Ruiqi-Deng/cyberluban-campuscar-group4/mechanical/Images/Overall-2.png

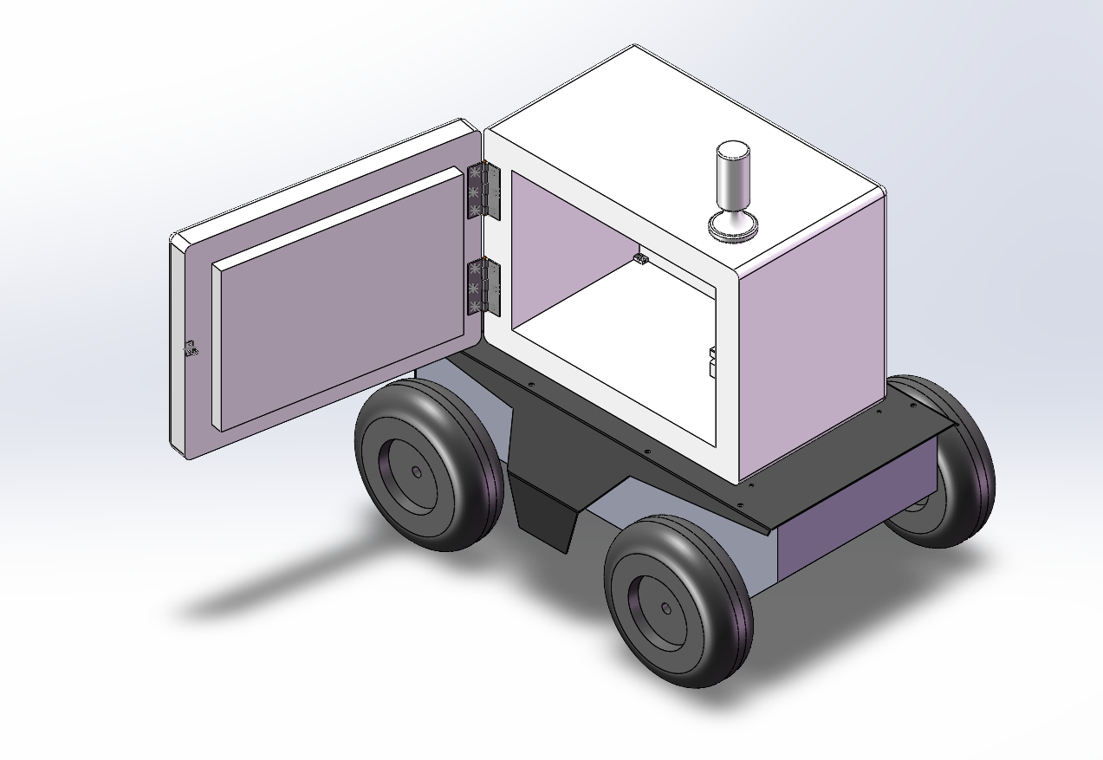
mechanical/Images/Overall-2.png
