Ruiqi-Deng/cyberluban-campuscar-group4/docs/测试记录/rtk天线/images/串口通信_POS帧.png

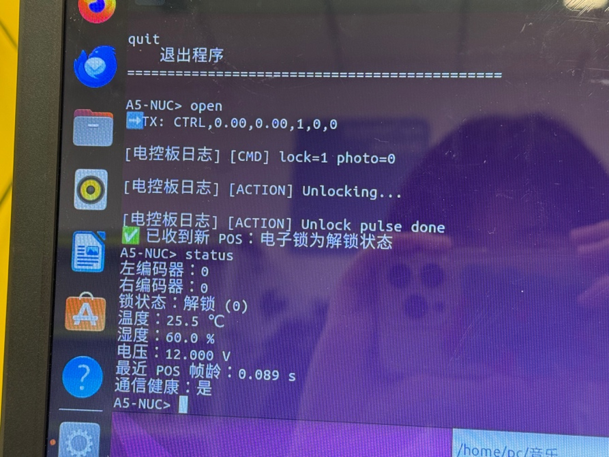
docs/测试记录/rtk天线/images/串口通信_POS帧.png
