Ruiqi-Deng/cyberluban-campuscar-group4/docs/测试记录/电子锁+温湿度传感器/电子锁+温湿度传感器联调记录.md

# 温湿度传感器 + 电子锁 联调日志

**测试人员**：杨飞扬
**测试日期**：2026年8月20日  
**测试环境**：ESP32 + AM2301(DHT22) + 12V电磁锁 + 继电器

## 测试结果

- AM2301 温湿度读取正常（22.5°C / 78.8%）
- 电子锁开关控制正常（LOCKED ↔ UNLOCKED）
- POS帧数据上报正常（温湿度+锁状态+电压）
- 串口通信稳定

## 证据

联调截图
