Ruiqi-Deng/cyberluban-campuscar-group4/docs/测试记录/rtk天线/images/rtk_数据传送.png

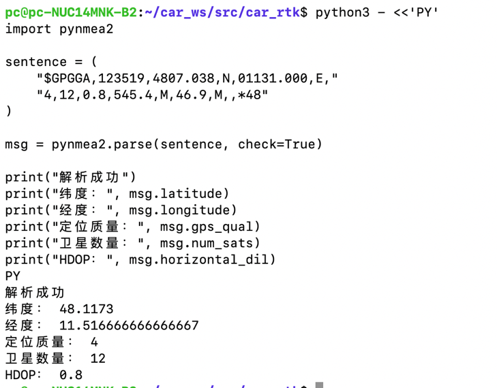
docs/测试记录/rtk天线/images/rtk_数据传送.png
