Ruiqi-Deng/cyberluban-campuscar-group4/docs/测试记录/rtk天线/images/状态机_状态流转截图.png

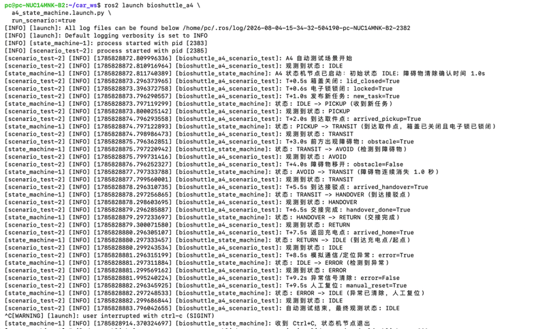
docs/测试记录/rtk天线/images/状态机_状态流转截图.png
