Ruiqi-Deng/cyberluban-campuscar-group4/docs/测试记录/电子锁+温湿度传感器/images/电子锁与温湿度传感器联调2.png

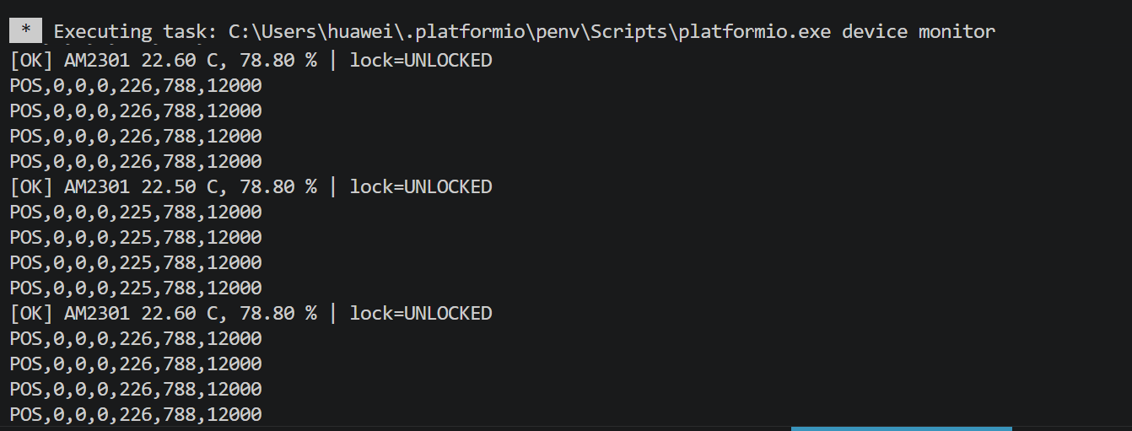
docs/测试记录/电子锁+温湿度传感器/images/电子锁与温湿度传感器联调2.png
