Ruiqi-Deng/cyberluban-campuscar-group4/mechanical/Images/Drawing Document.png

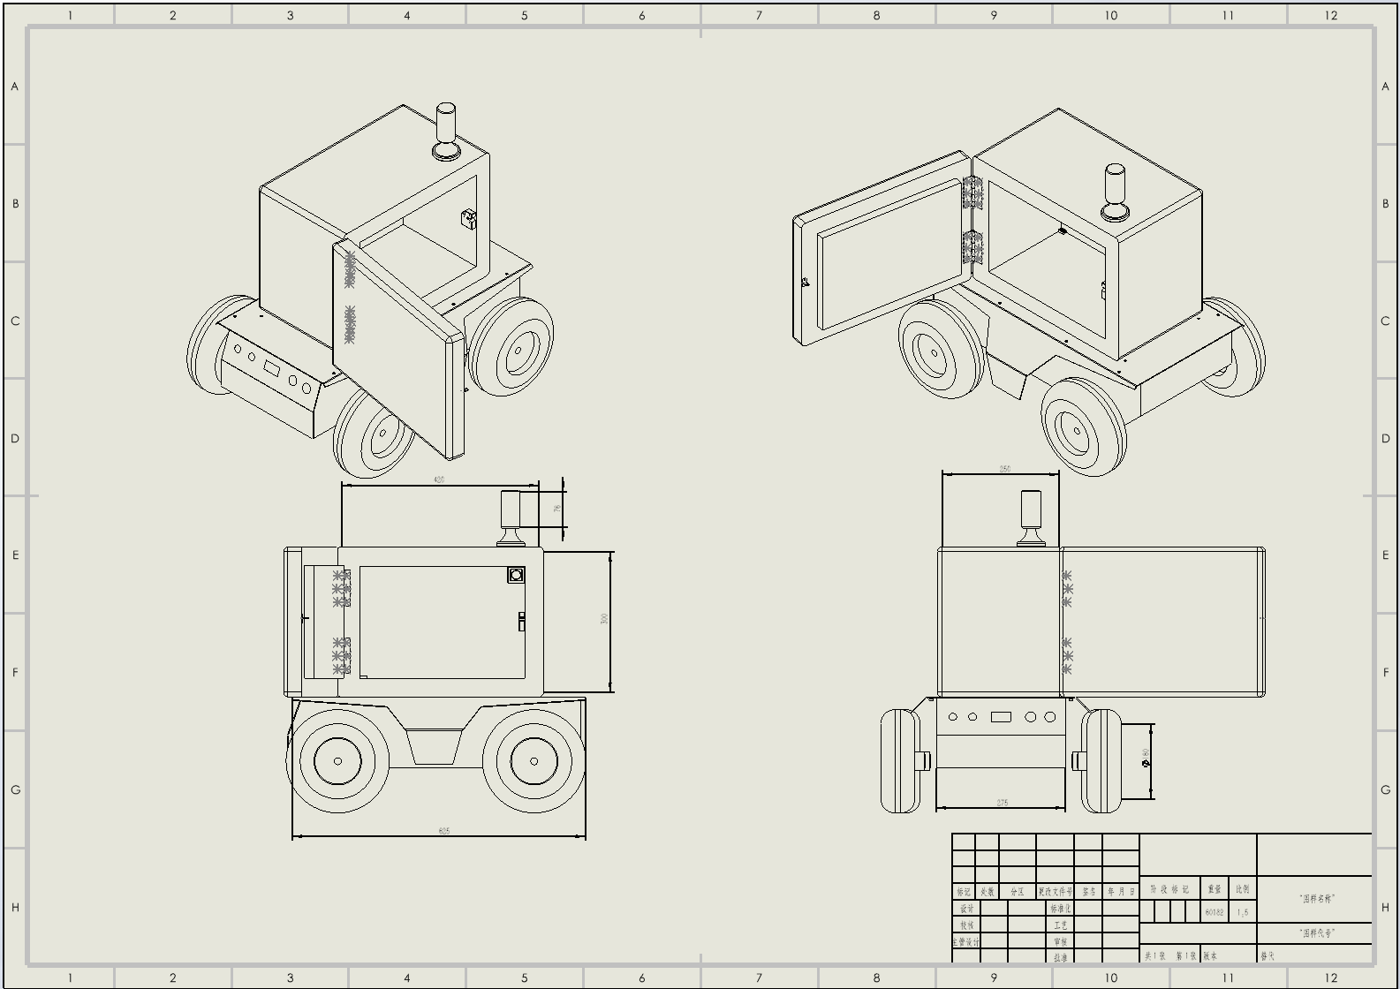
mechanical/Images/Drawing Document.png
