Ruiqi-Deng/cyberluban-campuscar-group4/mechanical/Images/Overall-1.png

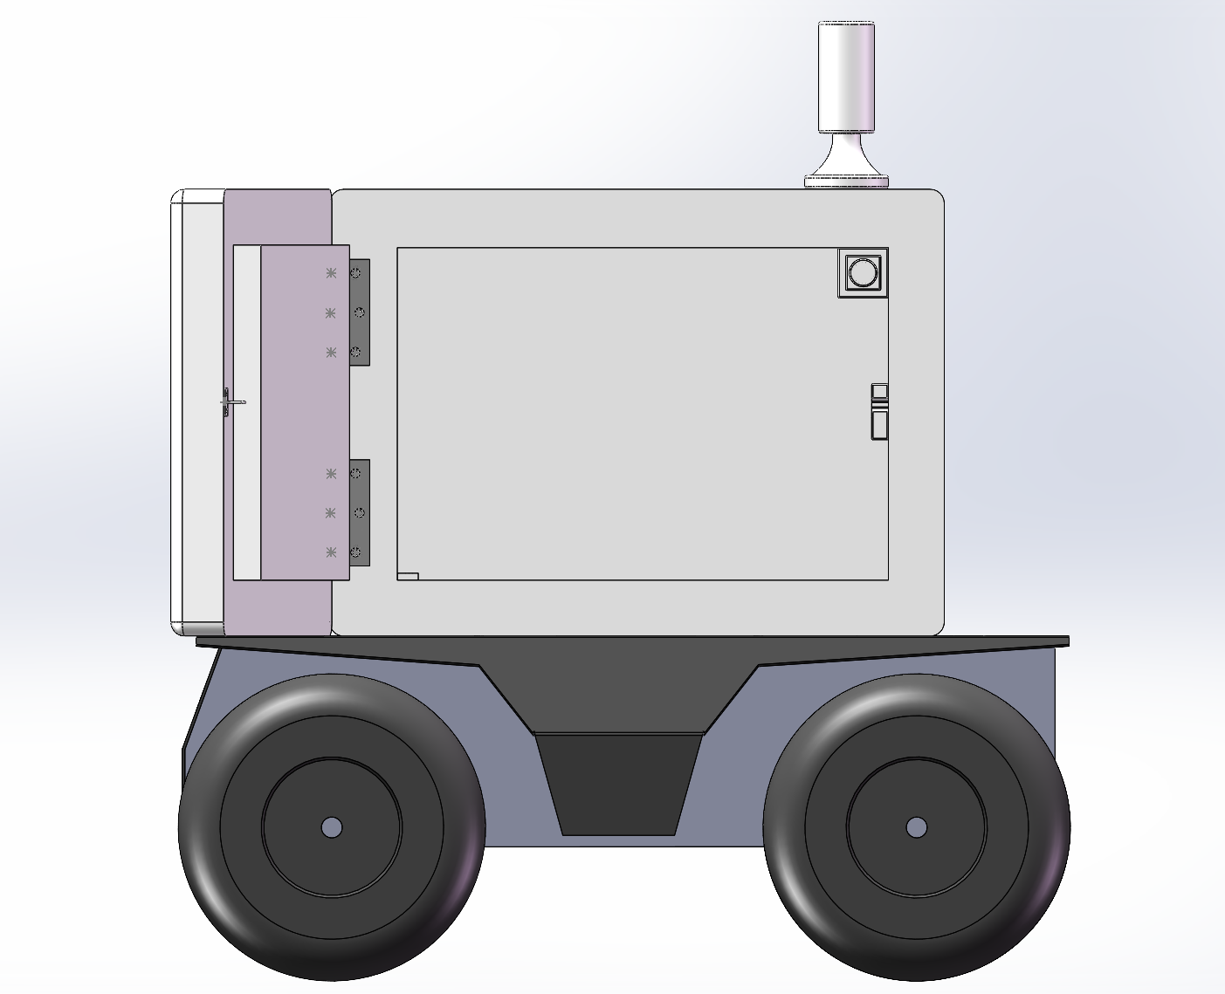
mechanical/Images/Overall-1.png
