Ruiqi-Deng/cyberluban-campuscar-group4/mechanical/Images/Overall-3.png

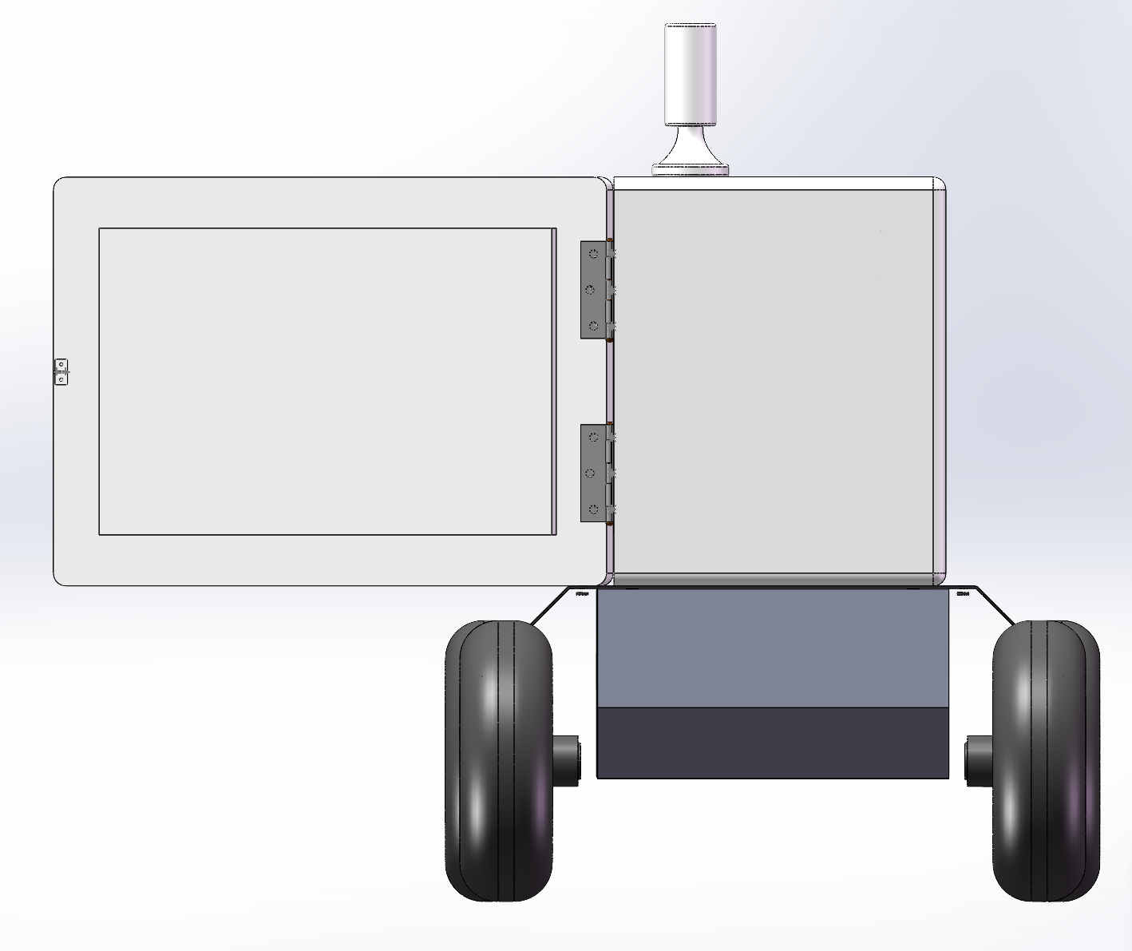
mechanical/Images/Overall-3.png
