Ruiqi-Deng/cyberluban-campuscar-group4/mechanical/Images/Overall-4.png

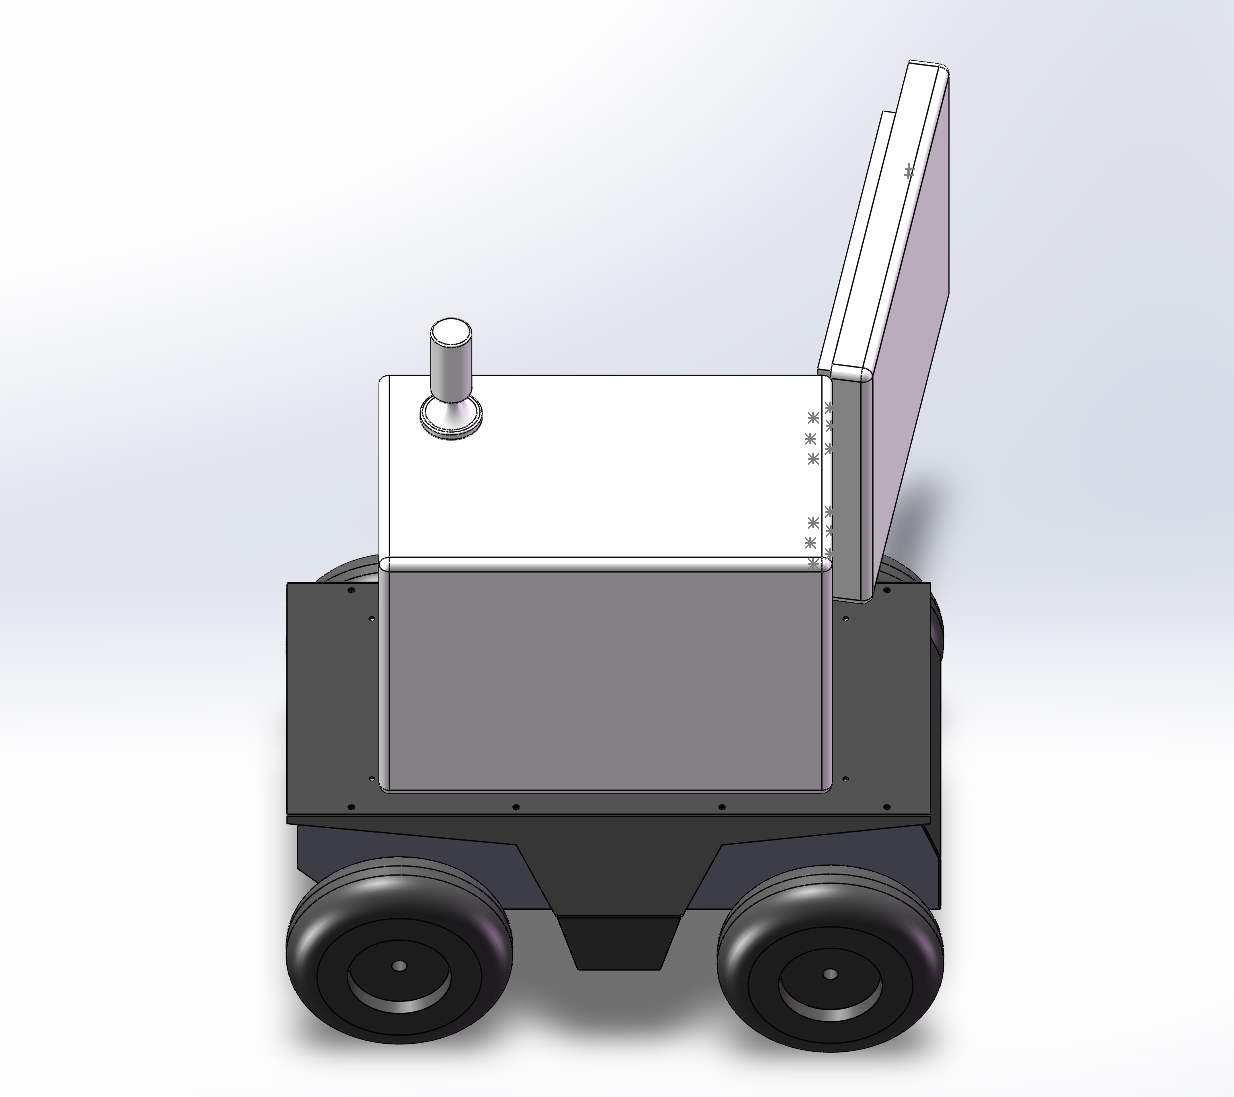
mechanical/Images/Overall-4.png
