Ruiqi-Deng/cyberluban-campuscar-group4/mechanical/CAD/箱体.SLDPRT

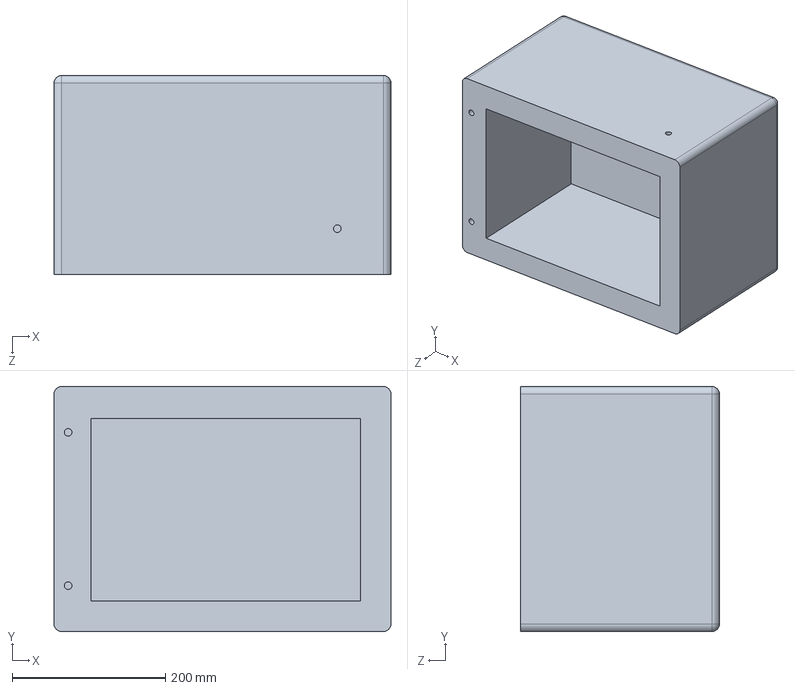
[picture p11: CAD file, 2026-08-21]
mechanical/CAD/箱体.SLDPRT
440.0 x 320.0 x 260.0 mm
