Ruiqi-Deng/cyberluban-campuscar-group4/mechanical/CAD/天线.SLDPRT

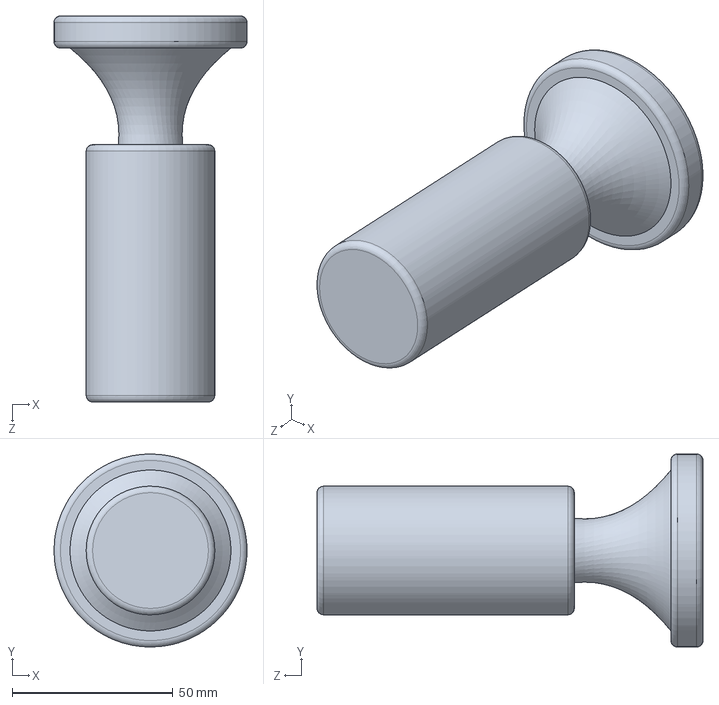
[picture p12: CAD file, 2026-08-21]
mechanical/CAD/天线.SLDPRT
60.0 x 60.0 x 120.0 mm
