Ruiqi-Deng/cyberluban-campuscar-group4/mechanical/CAD/四驱车.SLDPRT

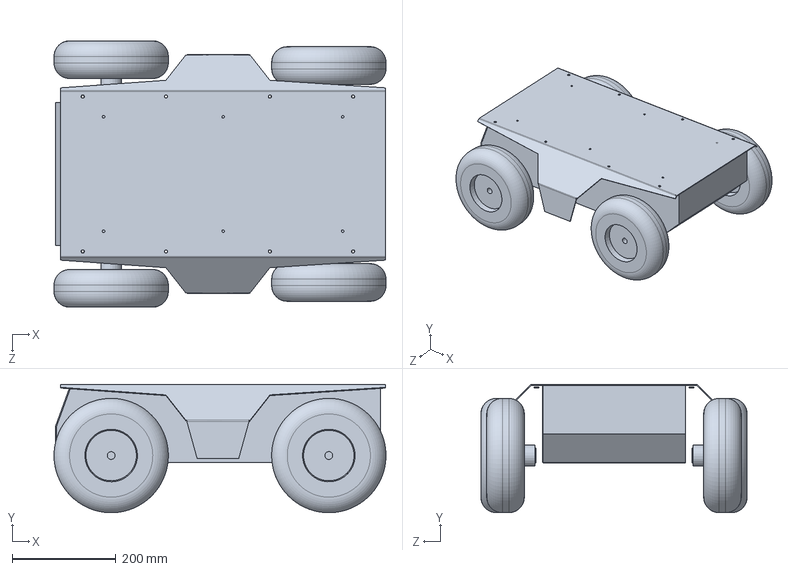
[picture p13: CAD file, 2026-08-20]
mechanical/CAD/四驱车.SLDPRT
638.6 x 247.0 x 512.4 mm
