Ruiqi-Deng/cyberluban-campuscar-group4/mechanical/CAD/箱盖.SLDPRT

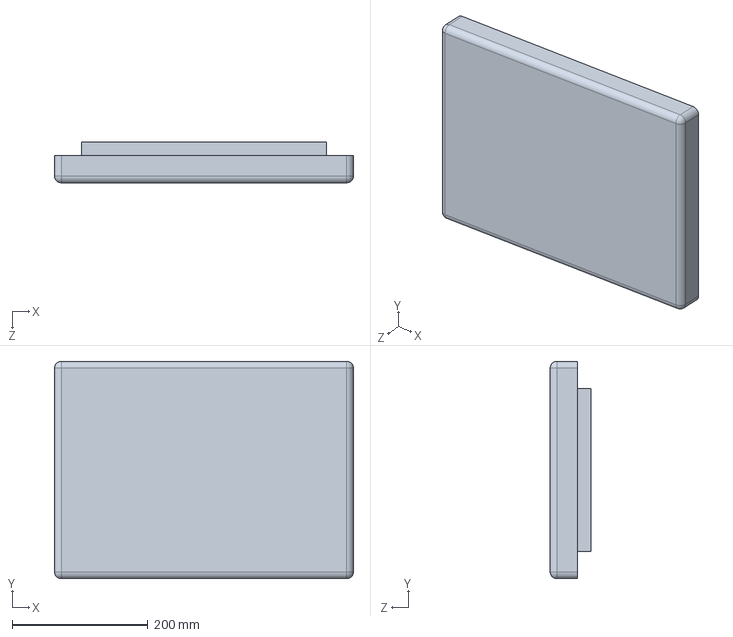
[picture p14: CAD file, 2026-08-20]
mechanical/CAD/箱盖.SLDPRT
440.0 x 320.0 x 60.0 mm
