Ruiqi-Deng/cyberluban-campuscar-group4/mechanical/CAD/转轴.SLDPRT

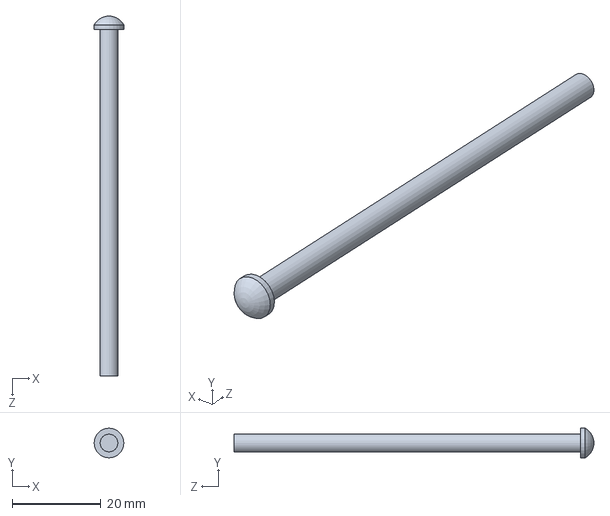
[picture p15: CAD file, 2026-08-20]
mechanical/CAD/转轴.SLDPRT
6.70 x 6.70 x 81.0 mm
