Ruiqi-Deng/cyberluban-campuscar-group4/mechanical/CAD/电子锁锁扣.SLDPRT

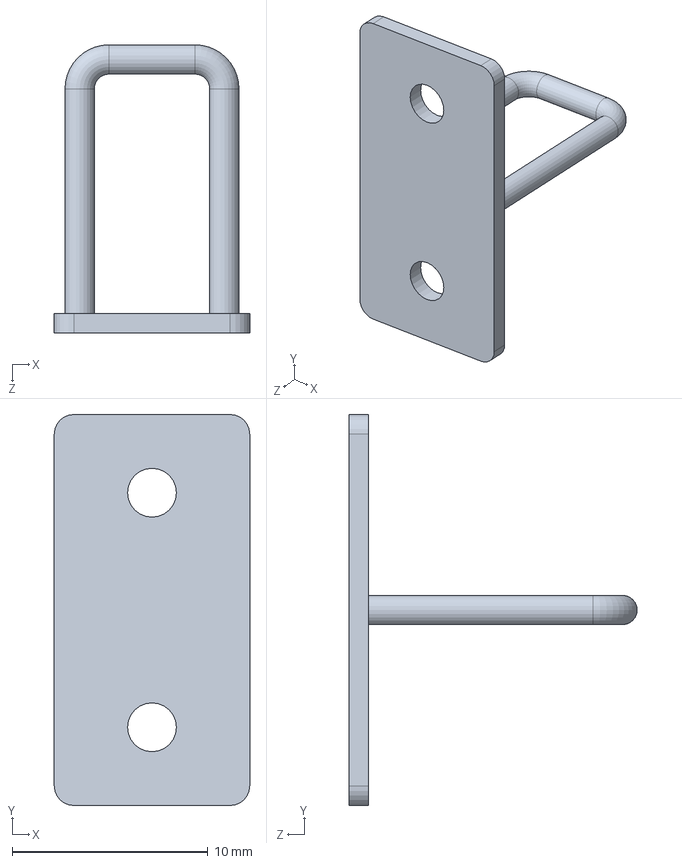
[picture p16: CAD file, 2026-08-20]
mechanical/CAD/电子锁锁扣.SLDPRT
10.0 x 20.0 x 14.8 mm
