Ruiqi-Deng/cyberluban-campuscar-group4/mechanical/CAD/电子锁锁体.SLDPRT

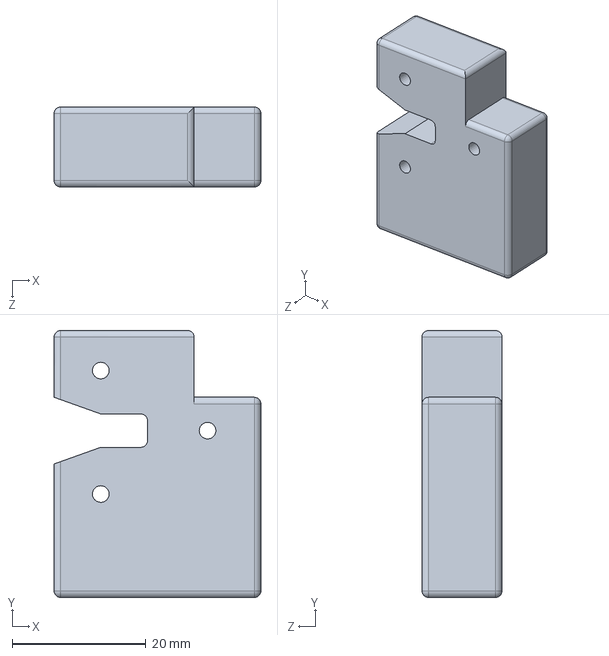
[picture p17: CAD file, 2026-08-20]
mechanical/CAD/电子锁锁体.SLDPRT
31.0 x 40.0 x 12.0 mm
