Ruiqi-Deng/cyberluban-campuscar-group4/mechanical/CAD/温湿度传感器.SLDPRT

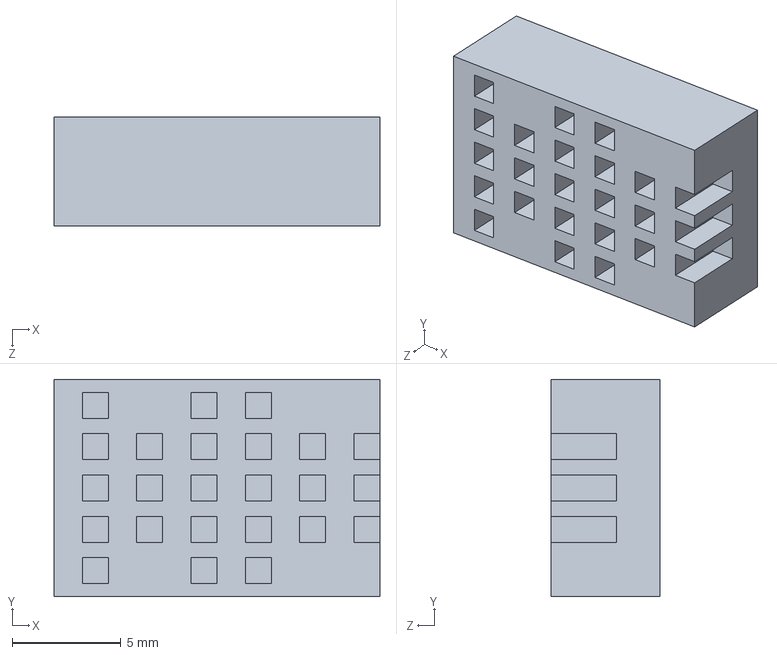
[picture p18: CAD file, 2026-08-20]
mechanical/CAD/温湿度传感器.SLDPRT
15.0 x 10.0 x 5.00 mm
