Ruiqi-Deng/cyberluban-campuscar-group4/mechanical/CAD/合页夹.SLDPRT

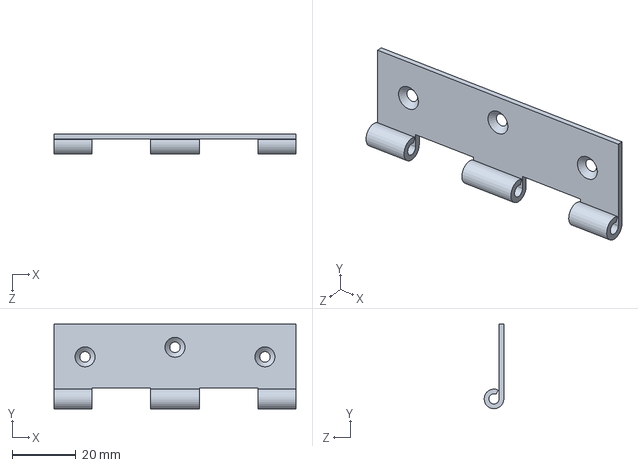
[picture p19: CAD file, 2026-08-20]
mechanical/CAD/合页夹.SLDPRT
76.0 x 26.5 x 6.20 mm
