Ruiqi-Deng/cyberluban-campuscar-group4/mechanical/CAD/相机.SLDPRT

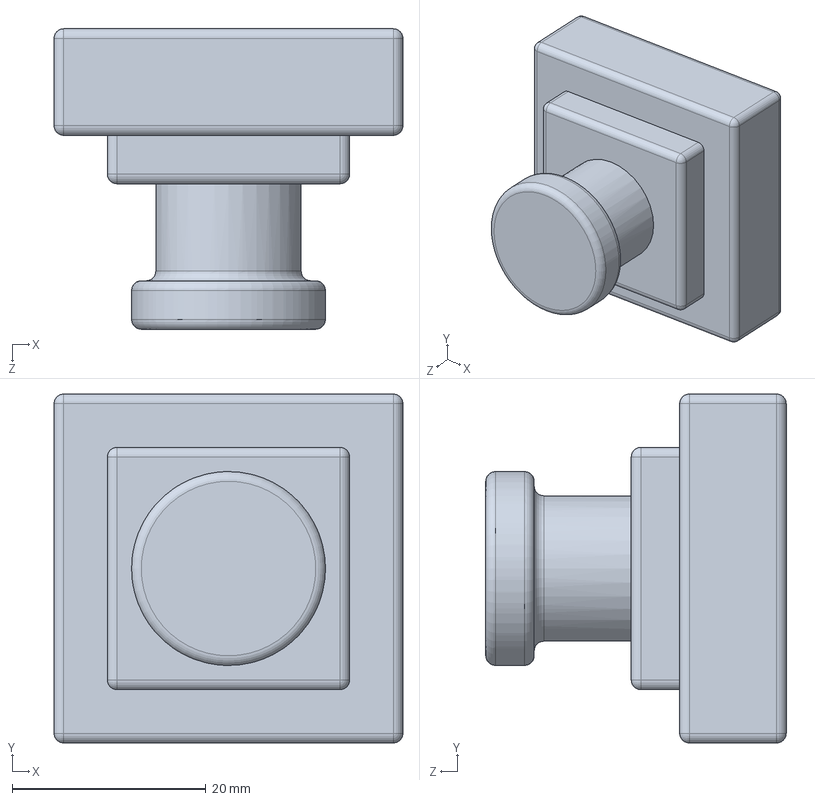
[picture p20: CAD file, 2026-08-20]
mechanical/CAD/相机.SLDPRT
36.0 x 36.0 x 31.0 mm
