Ruiqi-Deng/cyberluban-campuscar-group4/mechanical/CAD/接驳车装配体.SLDASM

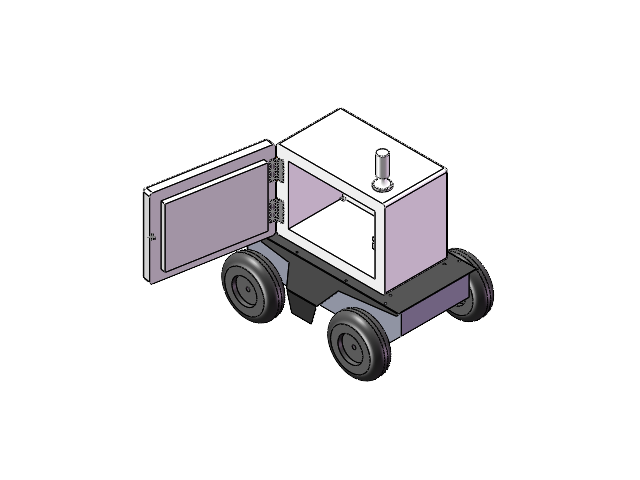
[picture p21: CAD file, 2026-08-21]
mechanical/CAD/接驳车装配体.SLDASM
箱体
相机
温湿度传感器
电子锁锁体
Pin x 2
hinge plate x 4
箱盖
电子锁锁扣
四驱车
天线
