Ruiqi-Deng/cyberluban-campuscar-group4/mechanical/CAD/铰链合页装配体.sldasm

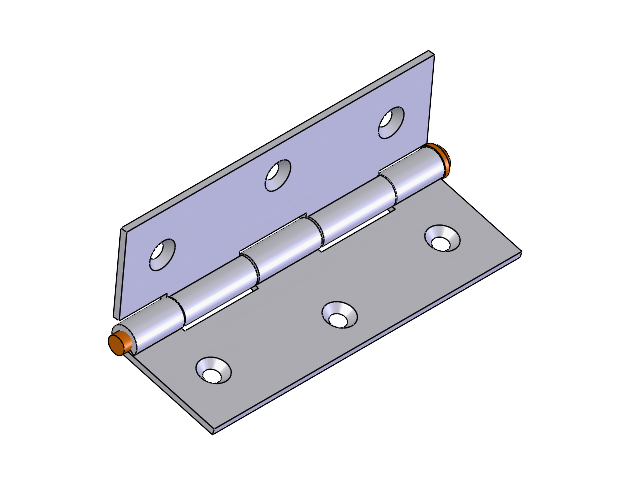
[picture p22: CAD file, 2026-08-20]
mechanical/CAD/铰链合页装配体.sldasm
Pin
hinge plate x 2
