Ruiqi-Deng/cyberluban-campuscar-group4/(list of files, cad)

Other CAD files:
mechanical/CAD/接驳车装配体-工程图.SLDDRW
