Ruiqi-Deng/cyberluban-campuscar-group4/docs/测试记录/小程序前端调试/小程序调试记录.md

# 小程序前端 测试日志

**测试人员**：陈铭敏  
**测试日期**：2026年8月21日  
**测试环境**：模拟小车运行  
**所属组别**：算法组  
**记录员**：陈铭敏

## 测试内容

BioShuttle接驳系统小程序前端功能测试，包括寄件、取件和物流看板三大核心页面。

## 测试过程

1. 寄件流程测试：填写起始地点、目的地、样品名称、温湿度要求
2. 取件流程测试：输入样品编码和取件码
3. 物流看板测试：查看历史任务列表和状态

## 测试结果

**寄件页面：**
- 起始地点可选“实验室”
- 目的地可选“校门口”
- 支持填写样品名称和温湿度要求
- 下单后任务自动生成

**取件页面：**
- 支持输入样品编码
- 支持输入4位取件码
- 验证后触发取件动作

**物流看板：**
- 任务列表显示正常
- 每个任务包含编号、样品名、路线、状态
- 状态同步更新（样品已取出并闭锁，任务完成）

## 测试结论

小程序前端三大页面（寄件、取件、看板）均可正常跳转和交互，在模拟小车运行环境下能正常展示任务状态。寄件、取件流程跑通，物流看板任务列表更新正常。

## 备注

当前为模拟小车运行环境测试，后续需接入真实后端API与小车联调。
