Ruiqi-Deng/cyberluban-campuscar-group4/docs/测试记录/小程序前端调试/images/小程序展示2.png

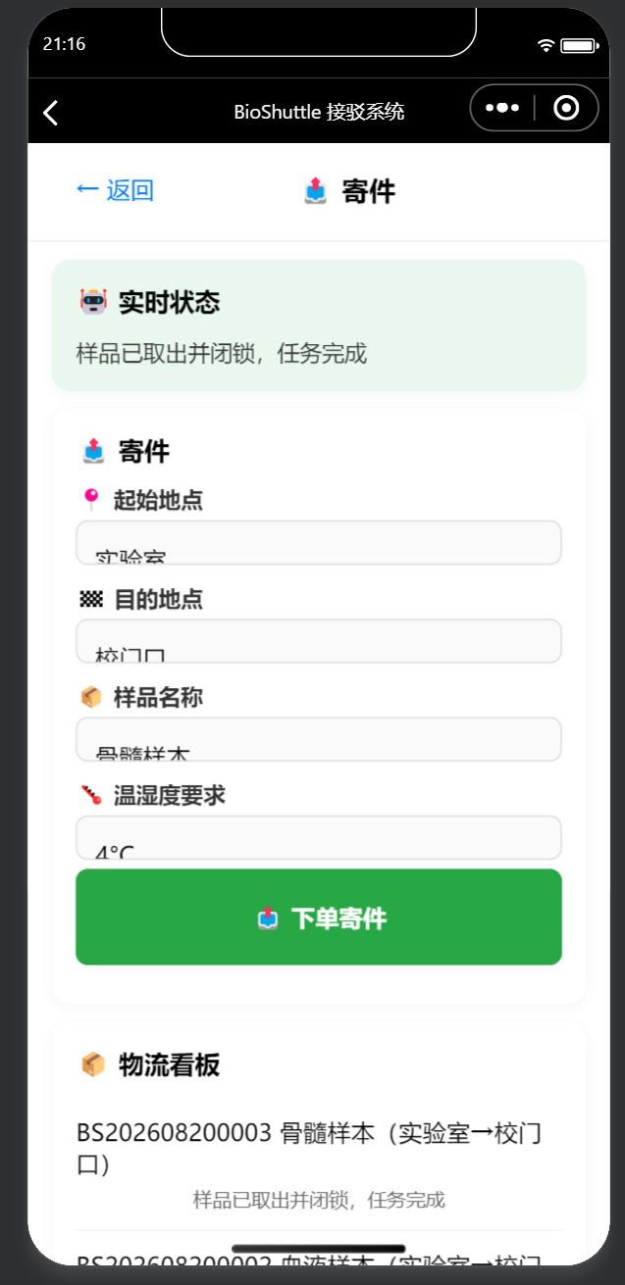
docs/测试记录/小程序前端调试/images/小程序展示2.png
