Ruiqi-Deng/cyberluban-campuscar-group4/docs/测试记录/相机模块/images/相机模块调试记录.jpg

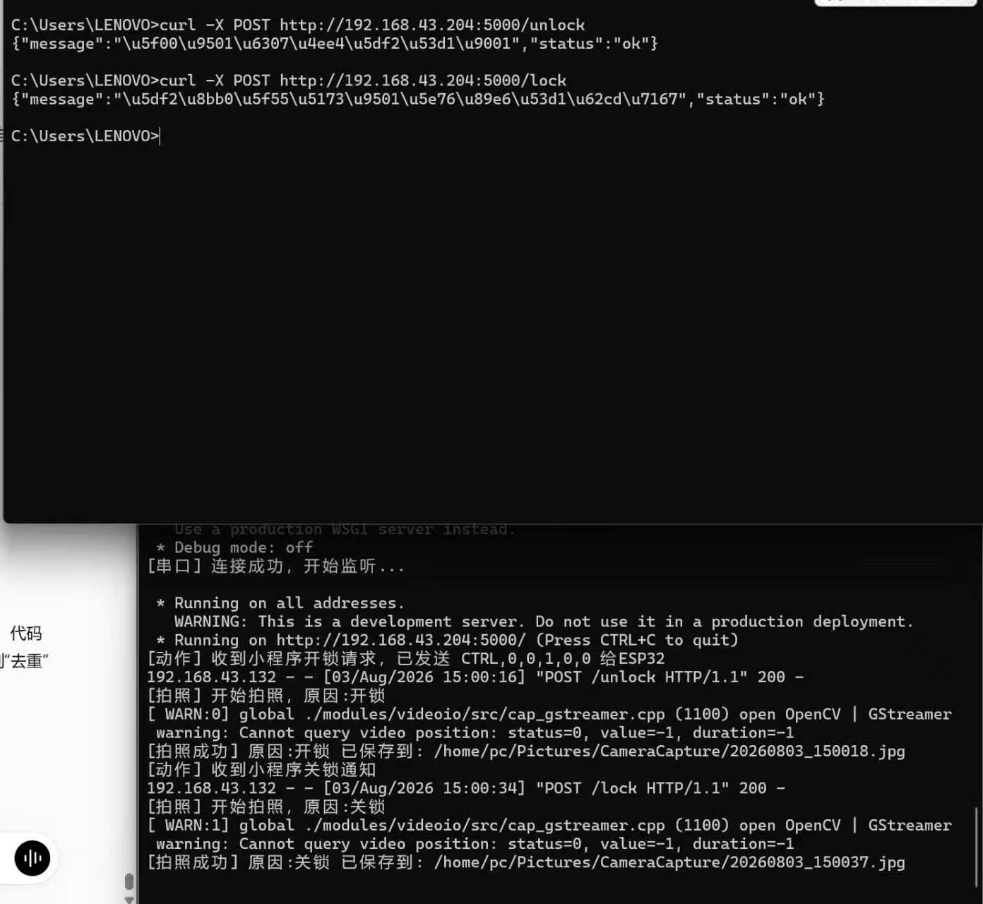
docs/测试记录/相机模块/images/相机模块调试记录.jpg
