Ruiqi-Deng/cyberluban-campuscar-group4/algorithm/simulation/bioshuttle_sim/config/localization.yaml

ekf_local_filter:
  ros__parameters:
    frequency: 30.0
    sensor_timeout: 0.2
    two_d_mode: true
    publish_tf: false
    print_diagnostics: true
    map_frame: map
    odom_frame: odom
    base_link_frame: base_footprint
    world_frame: odom

    odom0: /odom
    odom0_config: [true, true, false,
                   false, false, true,
                   true, false, false,
                   false, false, true,
                   false, false, false]
    odom0_differential: false
    odom0_relative: false

    imu0: /imu/data
    imu0_config: [false, false, false,
                  false, false, true,
                  false, false, false,
                  false, false, true,
                  false, false, false]
    imu0_differential: false
    imu0_relative: false
    imu0_remove_gravitational_acceleration: true

navsat_transform:
  ros__parameters:
    frequency: 10.0
    delay: 0.2
    magnetic_declination_radians: 0.0
    yaw_offset: 0.0
    zero_altitude: true
    publish_filtered_gps: true
    broadcast_utm_transform: false
    use_odometry_yaw: true
    wait_for_datum: false

ekf_global_filter:
  ros__parameters:
    frequency: 20.0
    sensor_timeout: 0.5
    two_d_mode: true
    publish_tf: false
    print_diagnostics: true
    map_frame: map
    odom_frame: odom
    base_link_frame: base_footprint
    world_frame: map

    odom0: /odometry/filtered
    odom0_config: [false, false, false,
                   false, false, false,
                   true, false, false,
                   false, false, true,
                   false, false, false]

    odom1: /odometry/gps
    odom1_config: [true, true, false,
                   false, false, false,
                   false, false, false,
                   false, false, false,
                   false, false, false]
    odom1_differential: false

    pose0: /apriltag/pose
    pose0_config: [true, true, false,
                   false, false, true,
                   false, false, false,
                   false, false, false,
                   false, false, false]
    pose0_differential: false
