Ruiqi-Deng/cyberluban-campuscar-group4/(commit log)

2026-08-19 添加电控组代码：Electronic Lock 电子锁模块
2026-08-19 添加电控组代码：小车运动模块
    [四驱车外形图.SLDPRT]
2026-08-19 添加算法组代码：rtk天线模块
    [四驱车外形图.SLDPRT]
2026-08-19 添加温湿度传感器模块：DS18B20+DHT22（独立文件夹）并调整文件结构
2026-08-19 更新代码：电子锁+温湿度传感器联调完成
2026-08-20 添加机械组建模文件：接驳车外观建模与零件装配图
    [合页夹.SLDPRT, 四驱车.SLDPRT, 接驳车装配体-工程图.SLDDRW, 接驳车装配体.SLDASM, 温湿度传感器.SLDPRT, 电子锁锁体.SLDPRT, 电子锁锁扣.SLDPRT, 相机.SLDPRT]
2026-08-20 添加算法组相机模块：工业相机操控代码并调整文件结构
2026-08-20 更新rtk调试记录，并完善文件结构“
2026-08-20 更新电子锁与温湿度传感器联调记录
2026-08-20 更新相机模块调试记录
2026-08-20 更新小程序调试记录
2026-08-20 更新README说明文档
2026-08-21 更新机械组建模：天线与装配体建模
    [合页夹.SLDPRT, 四驱车.SLDPRT, 天线.SLDPRT, 接驳车装配体-工程图.SLDDRW, 接驳车装配体.SLDASM, 温湿度传感器.SLDPRT, 电子锁锁体.SLDPRT, 电子锁锁扣.SLDPRT]
2026-08-21 添加算法组小程序开发代码
2026-08-21 添加串口通信协议”
2026-08-21 添加算法组仿真代码
    [bioshuttle_sim.urdf.xacro]
2026-08-21 更新README文件
2026-08-21 更新rtk调试记录2
2026-08-21 修改README
